HALtheWise/POE-lab3/version-2/libraries.md

# Libraries needed to build

In order to successfully build and install this program, you need to copy the following libraries into your sketchbook libraries directory (`~/Arduino/libraries` on Linux)

- [Adafruit v2 motor shield library](https://learn.adafruit.com/adafruit-motor-shield-v2-for-arduino/install-software)
- [Arduino PID library](https://github.com/br3ttb/Arduino-PID-Library/)
