HALtheWise/POE-lab3/report.pdf

# PoE Lab 03 : Line-Following Robot

## Yoonyoung Cho, Eric Miller

## October 13 2016

# 1 Introduction

Figure 1: Our Line Follower architecture, a two-wheeled differential drive robot equipped with two IR reflectance sensors positioned at the front.

In implementing the line-follower robot, we adopted three different, yet complementary schemes for control algorithms: Bang-Bang, PID, and Memory-Based control. In parallel to development of these methods, we also developed a simulator that would visualize a virtual hardware interface with native arduino code as a test bench for later phases in development and debugging.

# 2 Hardware

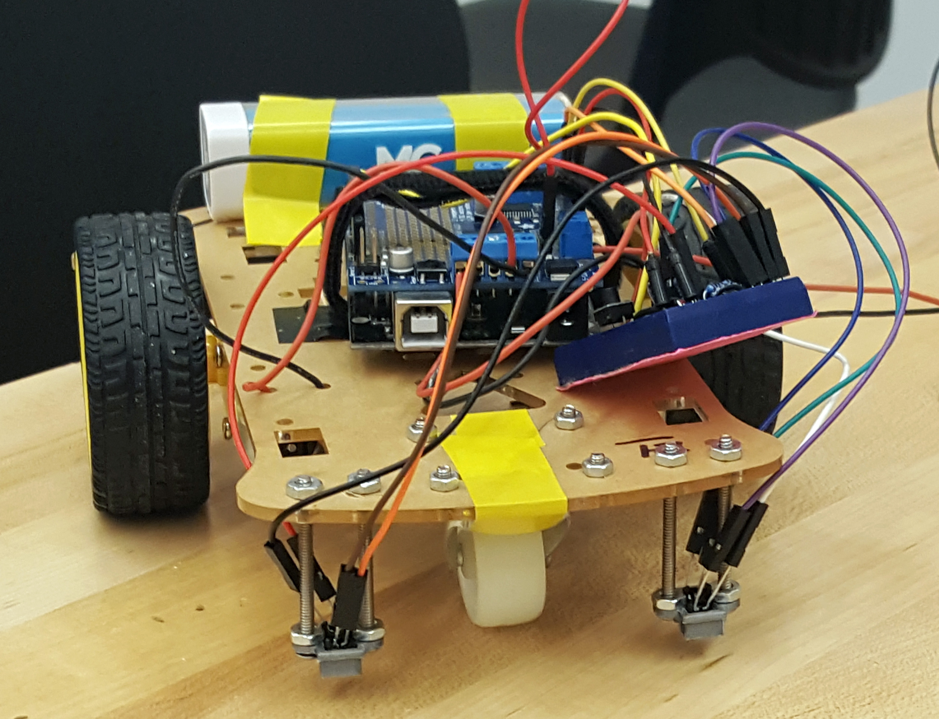
[picture p3: figure]

Figure 2: Final assembly of our robot.

In order to optimize for the reaction time from when the sensor detects a change in the environment, we reversed the orientation of the chassis so that what would otherwise be front would be the back side: i.e. we turned the Tadpole architecture to Delta.

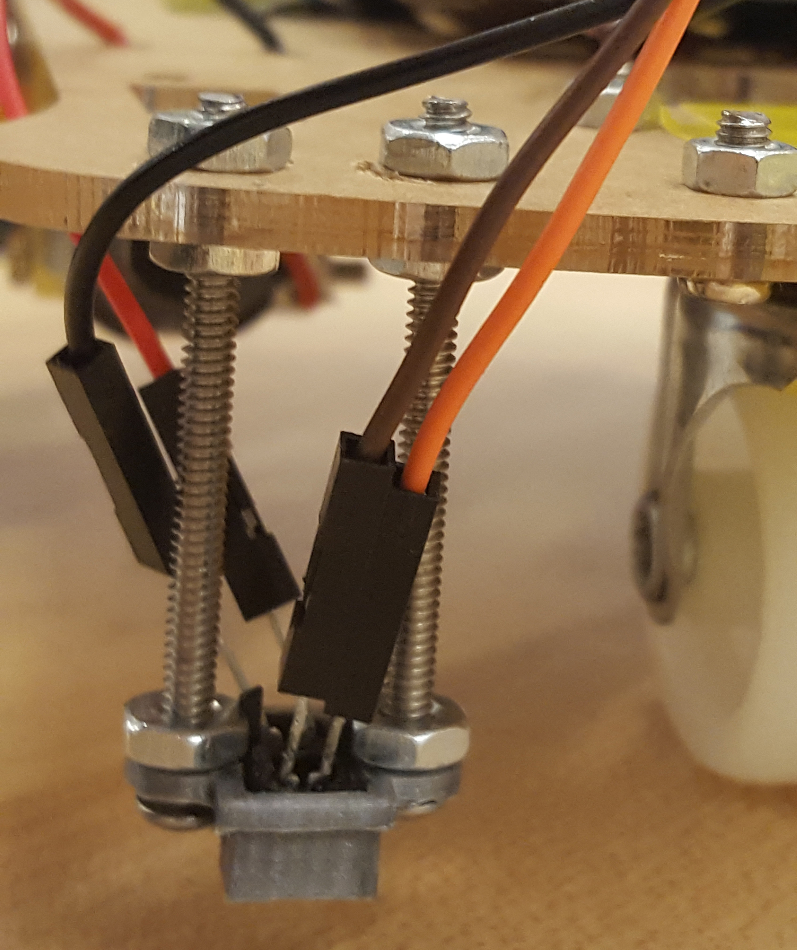
[picture p4: figure]

Figure 3: Mount for the IR reflectance sensor.

We have noticed that the sensor calibration was highly sensitive to the height at which the sensor was mounted; i.e.

### r = htan(fov/2)

where h is the height of the IR sensor, fov is its generic field of view, and r is the radius of the conical section model from which the sensor will poll the values. In addition to this, the signal strength would depend heavily on h as well, as some of the reflected light gets dissipated to the atmosphere, etc. To this end, we designed a minimalistic adjustable-height mount that operates with nuts and bolts, which made it not only convenient to disassemble, but also possible to rapidly adjust the calibration parameters as needed.

# 3 Control

## 3.1 BangBang

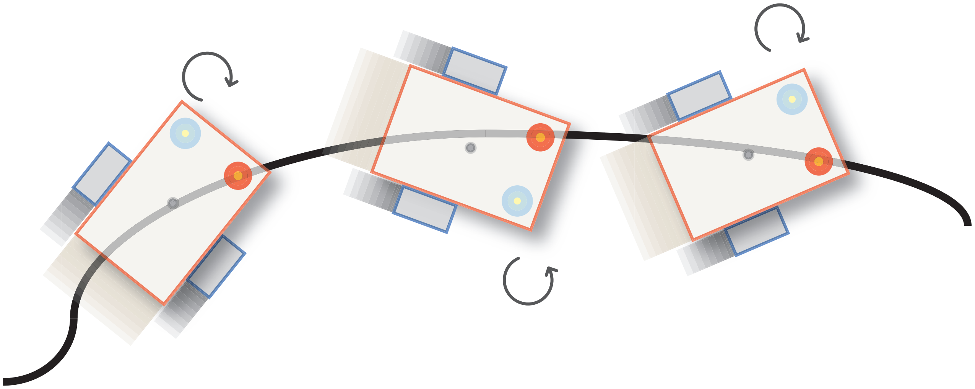
[picture p5: figure]

Figure 4: Simplified diagram that illustrates behavior of the Bang-Bang controller.

As an initial testing step, we employed the classical control algorithm for the Line-Follower Robot: BangBang. With Bang-Bang control, the robot is, at any given moment, under either of the two states: turning left or turning right. Because the robot cannot incorporate past trajectory into its decision-making process, its decisions are momentary and quite extreme, and the robot is always turning. Whereas this is certainly not optimal, the robot will follow the line in an oscillatory trajectory as the line would always be contained within the perimeters of the two sensors.

## 3.2 PID Control

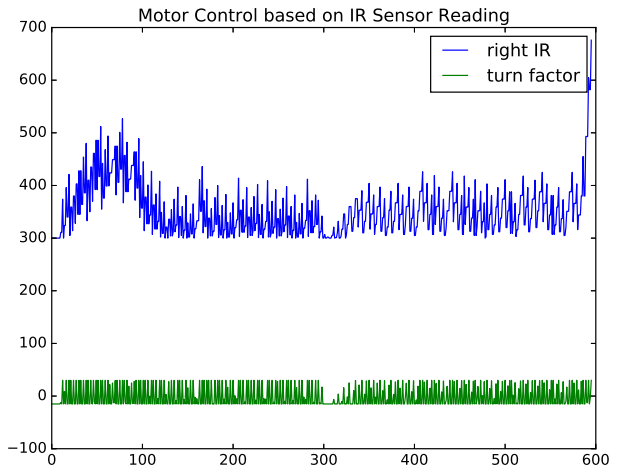
[picture p6: figure]
right IR turn factor

700 | Motor Control based on IR Sensor Reading

### Figure 5: Sensor vs. Motor output graph (run in simulator)

Unlike Bang-Bang control, where there are only two possible states in which the car could be in, the PID control can evaluate the error function in continuous space, which tends to result in a lot smoother trajectory. Our PID controller governed the turning factor of the robot: fixing the forward velocity of the robot essentially constrains the problem such that the control target and the error term collapses into a one-dimensional PID loop for determining sideways motion, i.e.

### ept = (1 + 1) irl − 300

800 − 300

− 1

ei

### t = ei

t−1 + ept dt

### edt =

ept − ept−1
dt

### et = kpept + kiei

### t + kdedt

### pl = pfw + etptn pr = pfw − etptn

Where e, p, l, r, fw, tn, and t represents error, power, left, right, forward-factor, turn-factor, and time, respectively. 300 and 800 are the empirical response readings¹ we have obtained from the Infrared sensor, distinguishing the tape and floor parts.
With untuned PID control trial to roughly verify that the code was working as intended, we obtained a time of 1:13 around the track. It should be noted that during the memorization phase of our final control algorithm, the PID controller (despite frequent stops in order to record the sectional path information) completed the track in less than a minute.

1voltage readings that map the ranges 0-255 to 0-5V.

## 3.3 Memory Prediction

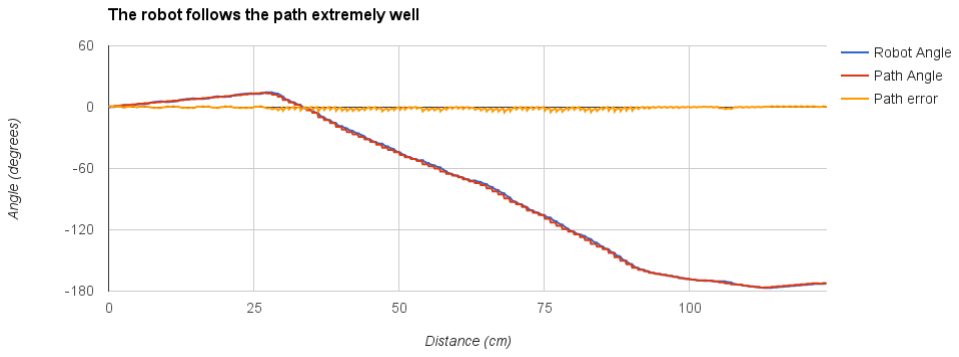
[picture p7: figure]

Figure 6: A snapshot of the pose of the robot along a segment in the path during one of the runs; the path is straight in the beginning (nearly constant angle) until a major 180 degree turn from 30cm until 90cm.

While PID is an incredibly powerful tool, its benefits primarily shine in situations where the behavior of the system varies unpredictably with time. At first glance, a line follower seems like a prime example of this because the shape of the upcoming line is unknown, but in reality, the nature of the course as a closed loop that is permanently affixed to the floor means that the path of the line is actually predictable, and that predictability can be harnessed to enhance the performance of the robot significantly. This insight gave rise to our third-generation algorithm, the memory-prediction follower, which circumnavigates the course twice, using the first run to collect readings on the precise curvature of the course and the second run to use those readings for improving the speed of the navigation.
Intuitively, this task would be easy if the behavior of the motors was perfectly repeatable from run to run because it would be possible to simply record the outputs on the first run and replay them faster for the second run. In reality, the low-quality DC motors we were provided are not anywhere near perfectly repeatable, as demonstrated in Figure 8, and exhibit variations of up to 10% from predictable behavior. We likely could have decreased that error substantially by incorporating true encoders onto the robot, but we wanted to stay within the letter of the lab description by using only the two IR sensors as input devices.

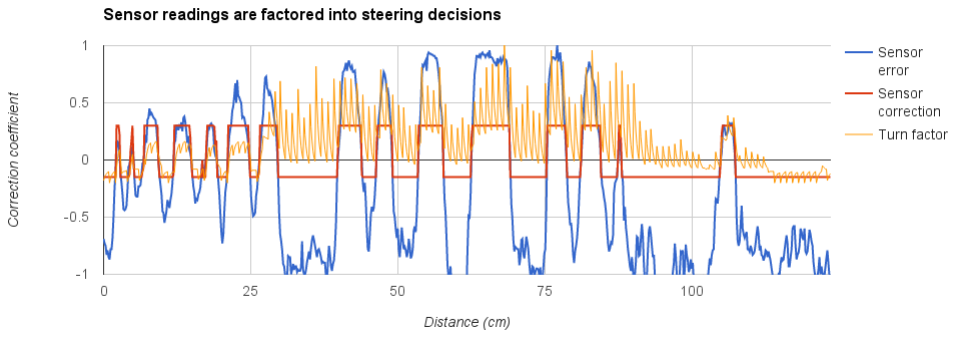
[picture p8: figure]

Figure 7: Sensor data is factored into the final steering corrections (shown in orange) but most of the input comes from error relative to the memorized path.

Because the encoder data we are generating from the motor commands is highly inaccurate, we needed to fuse it with traditional line sensor readings for it to be useful. We did this in two ways. One line sensor (after calibration scaling) was used as a source of a PID loop to update the robot’s estimated orientation in a way akin to following the line. We made the rates on this loop substantially lower than they would be for a pure sensor-based following solution because we could take advantage of the map data collected on the previous run. We placed the other sensor several inches away, much farther than a normal two-sensor follower, and used it exclusively to detect abrupt changes in curvature direction. These changes were used to reset the ”distance travelled” component of the robot’s position estimate. Every time the curvature changed, these two sensors switch roles, guaranteeing that the ”following” sensor will always be on the interior (concave) portion of the curving line.
By running this procedure without prior map data (and at low speed) we were able to built a map composed of seven segments that together build up the course. We stored these segments as lists of floating point values representing the estimated angle of the line at each point in relation to the angle at the start of that segment, with one value stored per centimeter of course. By using separate segments, we allowed ourselves to allocate appropriate amounts of memory and store configuration values associated with each piece of the course. Storing absolute angles instead of rates of curvature was intended to allow efficient computation of drive instructions from any point to any other, although either decision would likely have fallen within our performance requirements.

# 4 Calibration

## 4.1 Motor Characterization

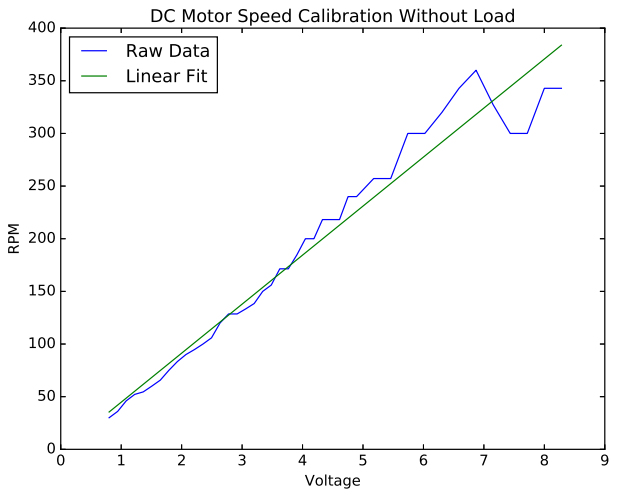
[picture p9: figure]

### Figure 8: Calibration Curve

In order to obtain better data with dead-reckoning, it was essential to have a reasonably precise estimate of the correlation between the power input to the motors and the output velocity. In order to characterize the

### motors, Below are the thus obtained relations:

### r = 3.25cm ω = 2π(46.55p − 1.80)rd/mn

### ~v = ωr

### = 6.5π(46.55p − 1.80)cm/mn

This data was obtained by attaching the tape on the shaft of the motors and counting the number of times that a tape would pass through a certain point in space within a defined amount of time; in practice, this was done by simply placing a finger in the trajectory of the tape and counting the number of collisions over a minute.

## 4.2 IR Reflectance Sensor Calibration

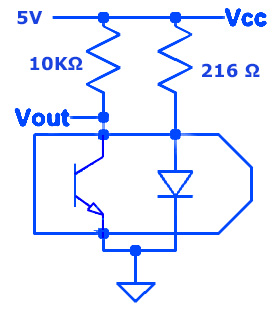
[picture p10: figure]

### Figure 9: Final schematics for interfacing with the IR Reflectance Sensor

The calibration process for the IR reflectance sensor was more of a guess-and-check binary search for the right resistor value that can distinguish between the reflectance responses from the floor and the tape. In order to smooth out the possible noise, we polled the readings for a set duration of the during the loop and updated the values at 10 milliseconds, which was significant enough to cancel the noise but small enough to facilitate rapid reaction.

# 5 Simulation

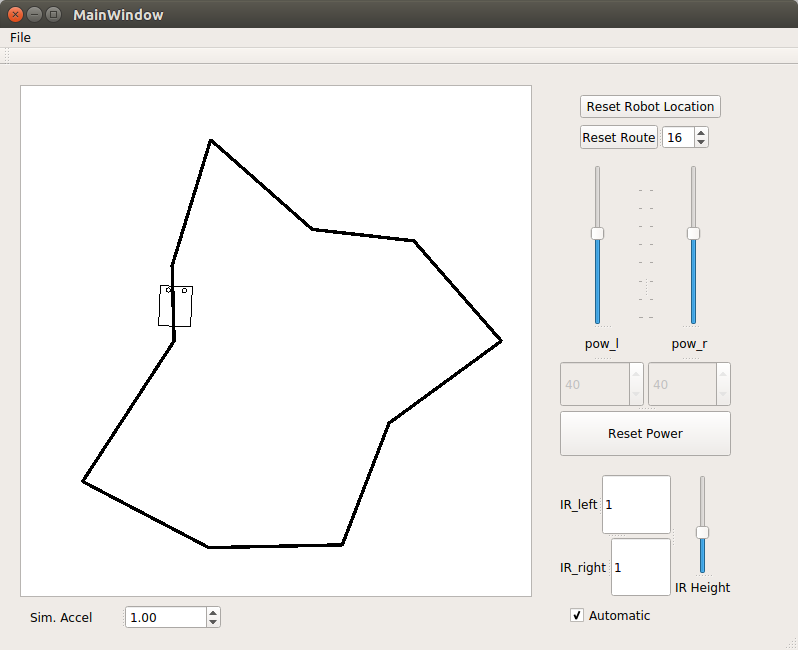
[picture p11: figure]

### Figure 10: Snapshot of the simulation during one of its autonomous runs

Initially, we developed the simulation as test bench for the software code before the chassis arrived for hardware integration testing. However, the process was delayed such that it was completed around the same

### time as the robot. At this point, we sought to use the simulator to fine-tune the kp, ki , and kd parameters, as

well as the offset and the position of the IR sensors, but it quickly turned out that adjusting those parameters didn’t take much effort.
What we ultimately ended up doing is to use the simulator as a relatively idealized environment, in parallel to the physical interaction of the robot with the actual course, where the inherent environmental noise and hardware limitations do not affect the logics of the code. Whereas we did not have time to actually utilize its powers as an optimization platform, it would be a reasonable next step to do so.

## 5.1 Kinematics

In the differential drive robot, the velocities of the two motor are responsible for dictating the motion of the

### robot; i.e. the two signals can be mixed to form the next-state estimate as follows:

The instantaneous center of curvature, denoted ICC, is the imaginary center of rotation along which the

### robot will rotate. it is found by²

:

### ICC = (x − Rsinθ, y + Rconsθ)

thus, at t = t + δt,

x

0
y

0
θ

0

- =

### cos(wδt) −sin(wδt) 0

sin(wδt) | cos(wδt) | 0
0 | 0 | 1

### x − ICCx y − ICCy

θ

- +

### ICCx ICCy wδt

# 6 Results & Reflection

Our robot, on its memorized run, was able to go through the course in under 30 seconds. [Demo Video] (https://www.youtube.com/watch?v=YWfVlXhnvgI) When we were electing to broaden the scope of this project such that the robot would take advantage of accumulated knowledge of the course from history, we knew we were taking on a task that was potentially impossible, and certainly very hard. Although we probably over-scoped the problem some, particularly by refusing to use encoders, we are proud we managed to make it work at all, let alone with the speed we eventually demonstrated.
Our robot’s coding strategy is more prone to external disturbances as a result of high reliance on odometry, but it has the potential of a far higher maximum speed: its anticipation of future positions and low reliance³ on IR sensor readings on its memorized run removes the dependency on the rate of the control loop, and could potentially allow it to perform at or near the limit of motor speed. With a few more sensors, we believe a map-based approach like ours would demonstrate clear superiority, and with one sensor, PID-like (stateless) approaches are probably best, but with the middle-ground of two line sensors, it isn’t clear which approach is superior.

2Refer to [this document] (https://chess.eecs.berkeley.edu/eecs149/documentation/differentialDrive.pdf) for more detailed derivation. 3around 10%

# 7 Appendix: Code

## 7.1 Memory-Prediction Implementation

### Main code (.ino)

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

7
8 #i n cl u d e <s t d l i b . h>

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

17
18 | // Setup s t a t e machine f o r r o b o t
19 | byte s t a t e = 1 ;
20 | c o n s t byte STATE STOP = 0 ;
21 | c o n s t byte STATE MEMORIZE = 1 ;
22 | c o n s t byte STATE REPLAY = 2 ;

23
24 | // I n cl u d e path management code
25 | #i n cl u d e ”odometry . h”
26 | #i n cl u d e ” p a th s . h”

27
28 // C o n t r olli n g c o n s t a n t s

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

31
32 | c o n s t i n t FORWARD POWER INITIAL = 3 0; // 0 . . . 2 5 5
33 | c o n s t i n t TURN POWER INITIAL = 3 0; // 0 . . . 2 5 5

34
35 c o n s t f l o a t OUTER TURN LIMIT = 0 . 0 5 ;

36
37 c o n s t i n t POWER REPLAY = 4 0; // 0 . . . 2 5 5

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

40
41 c o n s t byte SMOOTHING LENGTH = 4 ;

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

45
46 | c o n s t i n t MIN SENSOR LEFT | = 3 6 0;
47 | c o n s t i n t MAX SENSOR LEFT | = 7 8 0;
48 | c o n s t i n t MIN SENSOR RIGHT | = 6 0 0;
49 | c o n s t i n t MAX SENSOR RIGHT | = 8 8 0;

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

54
55 | A d a f r ui t M o t o r S hi el d AFMS = A d a f r ui t M o t o r S hi el d ( ) ;
56 | Ada fruit DCMotor ∗ l e f tM o t o r | = AFMS. getMotor ( 1 ) ;
57 | Ada fruit DCMotor ∗ ri gh tM o t o r = AFMS. getMotor ( 2 ) ;

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

61

62
63 i n t l e f t P o w e r = 0 , ri gh tP owe r = 0 ; // r an ge −2 5 5... 2 5 5

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

66
67 Pose r ob o tP o se ;

68
69 | Path path1 ( 2 0 0 , f a l s e ) ;
70 | Path path2 ( 1 0 0 , t r u e ) ;
71 | Path path3 ( 6 0 0 , f a l s e ) ;
72 | Path path4 ( 1 5 0 , t r u e ) ;
73 | Path path5 ( 2 0 0 , f a l s e ) ;
74 | Path path6 ( 1 0 0 , t r u e ) ;
75 | Path path7 ( 1 0 0 , f a l s e ) ;

76
77 | Path ∗ p a th s [ ] = {&path1 , &path2 , &path3 , &path4 , &path5 , &path6 , &path7 } ;
78 | c o n s t byte numPaths = 7 ;
79 | byte c u r r e n t P a t h I d = 0 ;

80
81 Path ∗ cu r ren tP a th = p a th s [ c u r r e n tP a t h I d ] ;

82
83 | // Setup PID c o n t r o l l e r
84 | d ouble P IDe r ro r =0, P ID se tp oin t =0, PIDoutput ;
85 | d ouble kp=1, ki =0,kd=0;

86
87 PID pid (&PIDerror , &PIDoutput , &P ID se tpoin t , kp , ki , kd , DIRECT) ;

88
89 | v oid se tup ( )
90 | {
91 | AFMS. b e gi n ( ) ;

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

100
101 l a s tAc ti onTime = m i l l i s ( ) ;

102
103 | // I n i t i a l i z e PID c o n t r o l l e r p a r ame te r s
104 | pid . SetMode (AUTOMATIC) ;
105 | pid . SetSampleTime (LOOP DURATION − 2 ) ;
106 | pid . Se tOu tpu tLimi t s ( −1, 1 ) ;

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

117
118 | // Used t o moderate debugging p r i n t o u t s with modulo .
119 | i n t loopCount = 0 ;

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

145

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

151
152 | i f ( s t a t e == STATE REPLAY) {
153 | // The memorizeLine f u n c ti o n d e ci d e d t o change t o STATE REPLAY
154 | // T r a n si ti o n from STATE MEMORIZE t o STATE REPLAY

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

157
158 | s t o p ( ) ;

159
160 | f o r ( i n t i =0; i<numPaths ; i++){
161 | p a th s [ i ]−>smooth (SMOOTHING LENGTH) ;

162
163 | S e r i a l . p r i n t l n ( i ) ;
164 | p a th s [ i ]−>writeOut ( ) ;
165 | }

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

171
172 | // Re se t t o the f i r s t path
173 | c u r r e n t P a t h I d = 0 ;
174 | cu r ren tP a th = p a th s [ 0 ] ;

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

179
180 | } e l s e i f ( s t a t e == STATE REPLAY) {

181
182 | r e pl a y Li n e ( l e f tA v g , rightAvg , dt ) ;

183
184 | i f ( loopCount % 50 == 0 ) {
185 | w r i t e P o s e S e r i a l ( ) ;
186 | }

187
188 | } e l s e {
189 | s t o p ( ) ;
190 | }

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

195

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

235
236 pid . Compute ( ) ;

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

251
252 | l e f t P o w e r = FORWARD POWER INITIAL + t u r nF a c t o r ∗ TURN POWER INITIAL;
253 | ri gh tP owe r | = FORWARD POWER INITIAL − t u r nF a c t o r ∗ TURN POWER INITIAL;

254

255
256 // Step 3 : Record the c u r r e n t motion i n t o the path .

257 cu r ren tP a th−>attemptUpdate ( &r ob o tP o se ) ;

258

259
260 // Step 4 : de te rmine whether the r ob o t has ended the c u r r e n t segment

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

269

270
271 | s t o p ( ) ;
272 | // d el a y ( 5 0 0 ) ;
273 | r ob o tP o se . r e s e t ( ) ;

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

282
283 | }

284
285 | // P ri n t debug i n f o rm a ti o n
286 | i f ( loopCount % 50 == 0 ) {
287 | w r i t e P o s e S e r i a l ( ) ;
288 | }
289 | }

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

293
294 | // Step 0 : Handle e x c e p ti o n f o r c o n t r o l p a r ame te r s on the 5 th segment ( i d =4)
295 | d ouble awayAdjustAmount = LINE ANGLE ADJUSTMENT RATE AWAY;
296 | i f ( c u r r e n tP a t h I d == 4 ) {
297 | awayAdjustAmount ∗= 1 . 8 ;
298 | }

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

313
314 r ob o tP o se . angleFrom += l i n e C o r r e c t i o n ;

315

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

318
319 PathPoint ∗ t a r g e t = cu r ren tP a th−>g e t P oi n t ( r ob o tP o se . di s tAl o n g ) ;

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

322 d ouble p a thE r r o r = t a r g e t −>wrappedAngle − r ob o tP o se . angleFrom ;

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

326
327 | l e f t P o w e r = POWER REPLAY ∗ ( 1 + t u r nF a c t o r ) ;
328 | ri gh tP owe r | = POWER REPLAY ∗ ( 1 − t u r nF a c t o r ) ;

329
330 // Step 3 : Determine whether t h i s segment o f path i s f i n i s h e d

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

337
338 | s t o p ( ) ;
339 | // d el a y ( 2 0 0 ) ;
340 | r ob o tP o se . r e s e t ( ) ;

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

348
349 | }

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

389 i f ( S e r i a l . a v a i l a b l e ( ) > 0 ) {

390
391 | S e r i a l . setTimeout ( 1 0 0 ) ;
392 | // Read f i r s t number from s e r i a l stream
393 | kp = S e r i a l . p a r s eFl o a t ( ) ;
394 | S e r i a l . re ad ( ) ;
395 | // Read sec ond number from s e r i a l stream
396 | ki = S e r i a l . p a r s eFl o a t ( ) ;
397 | S e r i a l . re ad ( ) ;
398 | // Read t h i r d number form s e r i a l stream
399 | kd = S e r i a l . p a r s eFl o a t ( ) ;
400 | S e r i a l . re ad ( ) ;

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

406
407 | pid . SetTunings ( kp , ki , kd ) ;
408 | w ri t e T u ni n g s S e ri al ( ) ;
409 | }
410 | }

411
412 | v oid w r i t e P o s e S e r i a l ( ) {
413 | S e r i a l . p ri n t ( ”Pose i s : \ t ” ) ;
414 | r ob o tP o se . writeOut ( ) ;
415 | S e r i a l . p r i n t l n ( ) ;
416 | }

417
418 | v oid w ri t e T u ni n g s S e ri al ( )
419 | {
420 | S e r i a l . p r i n t l n ( ”Tunings s e t t o ( kp , ki , kd ) = ” ) ;
421 | S e r i a l . p ri n t ( ”\ t ( ” ) ;
422 | S e r i a l . p ri n t ( kp ) ;
423 | S e r i a l . p ri n t ( ” , ” ) ;
424 | S e r i a l . p ri n t ( ki ) ;
425 | S e r i a l . p ri n t ( ” , ” ) ;
426 | S e r i a l . p ri n t ( kd ) ;
427 | S e r i a l . p ri n t ( ” ) \n” ) ;
428 | }

429
430 | v oid s t o p ( ) {
431 | l e f t P o w e r = 0 ;
432 | ri gh tP owe r = 0 ;
433 | d ri veM o t o r s ( ) ;
434 | }

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

439
440 n o rm alizeP owe r s (&l e f tP ow e r , &rightPower , 2 5 5 ) ;

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

454
455 }

456
457 | v oid getMeasurements ( i n t ∗ l e f tR e a d , i n t ∗ ri gh tRe ad )
458 | {
459 | ∗ l e f t R e a d = analogRead ( l e f t S e n s o r P i n ) ;
460 | ∗ ri gh tRe ad = analogRead ( ri g h t S e n s o r Pi n ) ;
461 | }

### Path library (.h)

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

9
10 | PathPoint ( ) ;
11 | } ;

12
13 | PathPoint : : PathPoint ( v oid ) {
14 | wrappedAngle = 0 ;
15 | }

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

26
27 b o ol u s e L e f t S e n s o r ; // = f a l s e ;

28
29 | v oid writeOut ( v oid ) ;
30 | b o ol attemptUpdate ( Pose ∗ p o se ) ;
31 | v oid smooth ( byte smoothingLength ) ;
32 | PathPoint ∗ g e t P oi n t ( d ouble di s tAl o n g ) ;
33 | } ;

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

40
41 p oi n t s = ( PathPoint ∗) m all oc ( s i z e o f ( PathPoint ) ∗ l e n g t h ) ;

42
43 | f o r ( i n t i = 0 ; i < a l l o c a t e d P o i n t s ; ++i )
44 | {
45 | p oi n t s [ i ] = PathPoint ( ) ;
46 | }

47
48 | p oi n t s [ 0 ] . wrappedAngle = 0 ;
49 | }

50
51 | PathPoint ∗Path : : g e t P oi n t ( d ouble di s tAl o n g ) {
52 | i n t inde x = min ( di s tAl on g , u s e d P oi n t s − 1 ) ;
53 | i f ( inde x < 0 )
54 | {
55 | r e t u r n NULL;
56 | }
57 | r e t u r n &p oi n t s [ inde x ] ;
58 | }

59

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

96
97 | p oi n t s [ i ] . wrappedAngle = a v e r a g e ;
98 | }
99 | }

### Odometry code (.h)

1 #i n cl u d e <Arduino . h>

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

18
19 | Pose : : Pose ( ) {
20 | r e s e t ( ) ;
21 | }

22
23 | v oid Pose : : writeOut ( v oid ) {
24 | S e r i a l . p ri n t ( ” (d , t h e t a ) = ( ” ) ;

25 | S e r i a l . p ri n t ( di s tAl o n g ) ;
26 | S e r i a l . p ri n t ( ” , ” ) ;
27 | S e r i a l . p ri n t ( angleFrom ) ;
28 | S e r i a l . p ri n t ( ” ) ” ) ;
29 | }

30
31 | v oid Pose : : r e s e t ( ) {
32 | di s tAl o n g = 0 ;
33 | angleFrom = 0 ;
34 | }

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

57
58 | d ouble l e f t P ow e rF r a c | = ad justPower ( l e f t P o w e r ) ;
59 | d ouble ri gh tP owe rF r ac = ad justPower ( ri gh tP owe r ) ;
60 | d ouble fo rwa rdSpeed = ( l e f t P ow e rF r a c + ri gh tP owe rF r ac ) / 2 ∗ MAX FORWARD SPEED;
61 | d ouble turnSpeed = ( ri gh tP owe rF r ac − l e f t P ow e rF r a c ) / 2 ∗ MAX TURN SPEED;

62
63 | di s tAl o n g += fo rwa rdSpeed ∗ tim e s t e p / 1 0 0 0 . 0 ;
64 | angleFrom += turnSpeed ∗ tim e s t e p / 1 0 0 0 . 0 ;
65 | }

## 7.2 Simulator Implementation

The simulator is a relatively large project with a lot of split definitions, so including all of them here would be impractical. Below are several more relevant parts that are directly related to either the computations or the functions of the simulator. For the full documentation, please visit the github link. (https://github.com/HALtheWise/POE-lab3/tree/simulator-memory)

### 7.2.1 Arduino Interface

### Adafruit MotorShield.h (declaration)

1 | #i f n d e f ADAFRUIT MOTORSHIELD H
2 | #d e f i n e ADAFRUIT MOTORSHIELD H

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

9
10 #d e f i n e FORWARD 1

11
12 #d e f i n e BACKWARD 2

13
14 | c l a s s Ada fruit DCMotor {
15 | p r i v a t e :
16 | i n t pin ;
17 | i n t speed ;
18 | p u bli c :
19 | Ada fruit DCMotor ( i n t pin ) ;
20 | v oid s e t S p e e d ( i n t ) ;
21 | v oid run ( byte&) ;
22 | } ;

23
24 | c l a s s A d a f r ui t M o t o r S hi el d
25 | {
26 | p r i v a t e :
27 | Ada fruit DCMotor ∗ m o t o r l e f t , ∗ m o t o r ri g h t ;
28 | p u bli c :
29 | A d a f r ui t M o t o r S hi el d ( ) ;
30 | ˜ A d a f r ui t M o t o r S hi el d ( ) ;
31 | v oid b e gi n ( ) ;
32 | Ada fruit DCMotor ∗ getMotor ( i n t ) ;
33 | } ;

34
35 #e n d i f // ADAFRUIT MOTORSHIELD H

### Adafruit MotorShield.cpp (definition)

1 #i n cl u d e ” A d a f r ui t M o t o r S hi el d . h”

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

5
6 Ada fruit DCMotor : : Ada fruit DCMotor ( i n t pin ) : pin ( pin ) {

7
8 }

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

17
18 | i f ( r o b o t ) {
19 | swi t c h ( pin ) {
20 | c a s e 1 : // l e f t
21 | robot−>setPowerL ( d i r ∗ speed ) ;
22 | break ;
23 | c a s e 2 :
24 | robot−>setPowerR ( d i r ∗ speed ) ;
25 | break ;
26 | }
27 | }

28
29 }

30
31 | v oid Ada fruit DCMotor : : s e t S p e e d ( i n t speed ) {
32 | t hi s −>speed = speed ;
33 | }

34
35 | A d a f r ui t M o t o r S hi el d : : A d a f r ui t M o t o r S hi el d ( )
36 | {
37 | t hi s −>m o t o r l e f t = new Ada fruit DCMotor ( 1 ) ;
38 | t hi s −>m o t o r ri g h t = new Ada fruit DCMotor ( 2 ) ;
39 | }

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

51
52 | v oid A d a f r ui t M o t o r S hi el d : : b e gi n ( ) {
53 | // don ’ t need t o do any thin g h e r e
54 | }

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

### arduino.h (declaration)

1 | #i f n d e f ARDUINO H
2 | #d e f i n e ARDUINO H

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

5
6 #d e f i n e BIN ( 2 )

7
8 | c o n s t i n t A0 = 0xA0 ;
9 | c o n s t i n t A1 = 0xA1 ;

10
11 | #i n cl u d e <i o s t re am>
12 | #i n cl u d e <b i t s e t >

13
14 | #i n cl u d e ” u t i l s . h”
15 | #i n cl u d e ”mainwindow . h”
16 | #i n cl u d e ” r o b o t . h”

17
18 | c l a s s | S e r i a l {

19
20 | p u bli c :
21 | v oid b e gi n ( i n t ) {
22 | | // i g n o r e baud r a t e
23 | }

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

30
31 | template<typename T>
32 | v oid p r i n t (T val , i n t f l a g ) {
33 | | i f ( f l a g == BIN ) {
34 | | s t d : : c ou t << s t d : : b i t s e t <8>( v al ) ;
35 | | }
36 | | // . . . not h a n dli n g o t h e r f l a g s ye t
37 | }

38
39 | template<typename T>
40 | v oid p r i n t l n (T v al ) {

41 | | s t d : : c ou t << v al << s t d : : e n dl ;
42 | }

43
44 | v oid p r i n t l n ( ) {
45 | | s t d : : c ou t << s t d : : e n dl ;
46 | }
47 | } ;

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

51
52 // Arduino APIs

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

59
60 #e n d i f // ARDUINO H

### arduino.cpp (definition)

1 | #i f n d e f ARDUINO H
2 | #d e f i n e ARDUINO H

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

5
6 #d e f i n e BIN ( 2 )

7
8 | c o n s t i n t A0 = 0xA0 ;
9 | c o n s t i n t A1 = 0xA1 ;

10
11 | #i n cl u d e <i o s t re am>
12 | #i n cl u d e <b i t s e t >

13
14 | #i n cl u d e ” u t i l s . h”
15 | #i n cl u d e ”mainwindow . h”
16 | #i n cl u d e ” r o b o t . h”

17
18 | c l a s s | S e r i a l {

19
20 | p u bli c :
21 | v oid b e gi n ( i n t ) {
22 | | // i g n o r e baud r a t e
23 | }

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

30
31 | template<typename T>
32 | v oid p r i n t (T val , i n t f l a g ) {
33 | | i f ( f l a g == BIN ) {
34 | | s t d : : c ou t << s t d : : b i t s e t <8>( v al ) ;
35 | | }
36 | | // . . . not h a n dli n g o t h e r f l a g s ye t
37 | }

38
39 | template<typename T>
40 | v oid p r i n t l n (T v al ) {
41 | | s t d : : c ou t << v al << s t d : : e n dl ;
42 | }

43
44 | v oid p r i n t l n ( ) {
45 | | s t d : : c ou t << s t d : : e n dl ;

46 | }
47 | } ;

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

51
52 // Arduino APIs

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

59
60 #e n d i f // ARDUINO H

### 7.2.2 System Definition

### Route.h (declaration)

1 | #i f n d e f ROUTE H
2 | #d e f i n e ROUTE H

3
4 | #i n cl u d e <QVector>
5 | #i n cl u d e <QPointF>
6 | #i n cl u d e <QPolygonF>
7 | #i n cl u d e <QGraphicsPolygonItem>
8 | #i n cl u d e <QPen>
9 | #i n cl u d e <QString>
10 | #i n cl u d e <QFile>
11 | #i n cl u d e <QTextStream>

12
13 #i n cl u d e ” u t i l s . h”

14
15 | s t r u c t Route
16 | {
17 | //QVector<QPointF> r o u t e ;
18 | QPolygonF p ol y ;
19 | QGraphicsPolygonItem p ol y i t em ;
20 | QPen routePen ;
21 | p u bli c :
22 | Route ( ) ;

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

27
28 | v oid s a ve ( c o n s t QString& fil e n am e ) ;
29 | v oid l o a d ( c o n s t QString& fil e n am e ) ;
30 | } ;

31
32 e x t e r n Route∗ r o u t e ;

33
34 #e n d i f // ROUTE H

### Route.cpp (definition)

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

4
5 | c o n s t d ouble R MIN = PXL DIMS / 8;
6 | c o n s t d ouble R MAX = PXL DIMS / 2;

7
8 Route∗ r o u t e ;

9
10 Route : : Route ( )

11 | {
12 | QBrush r ou teB ru sh = QBrush ( QColor : : fromRgb ( 0 , 0 , 0 ) ,Qt : : S oli d P a t t e r n ) ;
13 | routePen = QPen( routeBrush , c2p ( 1 . 7 ) ) ;
14 | }

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

18
19 | QVector<QPointF> r o u t e ;

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

23
24 | f o r ( i n t i =0; i<n ; ++i ) {
25 | f l o a t t = ( 2 ∗ M PI ) ∗ i / n ;
26 | f l o a t r = R MIN + (R MAX − R MIN) ∗ f l o a t ( rand ( ) ) /RANDMAX;
27 | r o u t e . push back ( QPointF ( x + r ∗ c o s ( t ) , y + r ∗ s i n ( t ) ) ) ;
28 | }
29 | s t d : : c ou t << ”N : ” << n << ” ROUTE SIZE : ” << r o u t e . s i z e ( ) << s t d : : e n dl ;
30 | r e s e t ( r o u t e ) ;
31 | }

32
33 | v oid Route : : r e s e t ( c o n s t QVector<QPointF> &r o u t e ) {
34 | // r e s e t from v e c t o r
35 | p ol y = QPolygonF ( r o u t e ) ;
36 | p ol y i t em . s e tP ol y g o n ( p ol y ) ;
37 | p ol y i t em . se tPen ( routePen ) ;
38 | }

39
40 | v oid Route : : s a ve ( c o n s t QString& fil e n am e ) {
41 | // s a ve r o u t e t o f i l e
42 | QFile f i l e ( fil e n am e ) ;
43 | i f ( f i l e . open ( QIODevice : : ReadWrite ) ) {
44 | QTextStream stream (& f i l e ) ;

45
46 | f o r ( auto& p : p ol y ) {
47 | stream << p . x ( ) << ’ , ’ << p . y ( ) << ’ \n ’ ;
48 | }
49 | }
50 | f i l e . c l o s e ( ) ;
51 | }

52
53 | v oid Route : : l o a d ( c o n s t QString& fil e n am e ) {
54 | // l o a d r o u t e from f i l e
55 | QFile f i l e ( fil e n am e ) ;
56 | i f ( f i l e . open ( QIODevice : : ReadOnly ) ) {
57 | QTextStream stream (& f i l e ) ;
58 | QVector<QPointF> r o u t e ;

59
60 | w hil e ( ! stream . atEnd ( ) ) {
61 | QString l i n e = stream . r e a dLi n e ( ) ;
62 | Q S t ri n gLi s t p t s = l i n e . s p l i t ( ” , ” ) ;
63 | QPointF pt ( p t s [ 0 ] . t oFl o a t ( ) , p t s [ 1 ] . t oFl o a t ( ) ) ;
64 | r o u t e . push back ( pt ) ;
65 | }

66
67 | f i l e . c l o s e ( ) ;
68 | Route : : r e s e t ( r o u t e ) ;
69 | }
70 | }

### Robot.h (declaration)

1 | #i f n d e f ROBOT H
2 | #d e f i n e ROBOT H

3
4 | #i n cl u d e <QObject>
5 | #i n cl u d e <QPointF>

6
7 #i n cl u d e <QPolygonF>

8
9 | #i n cl u d e <QGraphicsRectItem>
10 | #i n cl u d e <QG r aphic sEllip se I tem>

11
12 #i n cl u d e <QGraphicsScene>

13
14 | #i n cl u d e ” u t i l s . h”
15 | #i n cl u d e ” r o b o ti t em . h”

16

17
18 | c l a s s Robot
19 | {

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

37
38 | RobotItem∗ body ;

39
40 | p u bli c :
41 | Robot ( QGraphicsScene& scene ,
42 | QPointF pos , f l o a t the t a ,
43 | QPointF i r O f f s e t , f l o a t h , f l o a t f o v ) ;
44 | ˜Robot ( ) ;

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

52
53 | v oid setPowerR ( i n t r ) ;
54 | v oid setPowerL ( i n t l ) ;

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

58
59 | v oid s e t IRH ei g h t ( f l o a t h ) ;

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

64
65 e x t e r n Robot∗ r o b o t ;

66
67 #e n d i f // ROBOT H

### Robot.cpp (definition)

1 | #i n cl u d e ” u t i l s . h”
2 | #i n cl u d e ” r o b o t . h”

3

4 #i n cl u d e <i o s t re am>

5
6 | // 1 p xl = . 5 cm
7 | // 270 x 270 cm world

8
9 // r o b o t = 20 x16 cm

10
11 Robot∗ r o b o t = n u l l p t r ;

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

16
17 | // RobotBody
18 | Robot : : Robot ( QGraphicsScene& scene , QPointF pos , f l o a t the t a , QPointF i r O f f s e t , f l o a t h ,
| f l o a t f o v ) :
19 | pos ( pos ) ,
20 | t h e t a ( t h e t a ) ,
21 | i r O f f s e t ( i r O f f s e t ) ,
22 | h ( h ) ,
23 | f o v ( f o v ) ,
24 | c r ( coneRadius ( h , f o v ) )
25 | {
26 | v e l l = v e l r = 0 . ;

27
28 | body = new RobotItem ( pos , QPointF (ROBOT LENGTH,ROBOT WIDTH) , i r O f f s e t , the t a , c r ) ;
29 | // RobotItem w i l l t a ke c a r e o f g r a p hi c s
30 | s c e n e . addItem ( body ) ;
31 | }

32
33 | Robot : : ˜ Robot ( ) {
34 | i f ( body ) {
35 | d e l e t e body ;
36 | body = n u l l p t r ;
37 | }
38 | }

39
40 | v oid Robot : : r e s e t ( QPointF p , f l o a t t ) {
41 | pos=p ; t h e t a=t ;
42 | body−>s e t P o s ( pos , t h e t a ) ;
43 | }

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

49
50 | t h e t a = atan2 ( pos . y ( ) − d s t y , d s t x − pos . x ( ) ) ;

51
52 }

53
54 | v oid Robot : : move ( f l o a t d el t a , f l o a t d the t a ) {
55 | t h e t a += d the t a ∗ DT;
56 | pos += d e l t a ∗ QPointF ( c o s ( t h e t a ) , −s i n ( t h e t a ) ) ∗ DT;
57 | update ( ) ;
58 | }

59
60 | v oid Robot : : update ( ) {
61 | f l o a t w = ( v e l r − v e l l ) / WHEEL DISTANCE;
62 | i f (w != 0 ) {
63 | f l o a t R = ( v e l l + v e l r ) / ( 2∗w) ;

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

68
69 | f l o a t x = pos . x ( ) ;
70 | f l o a t y = pos . y ( ) ;

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

73
74 | pos . setX (
75 | c o s (−w∗DT) ∗ ( x − i c c x ) +
76 | −s i n (−w∗DT) ∗ ( y − i c c y ) +
77 | i c c x
78 | ) ;
79 | pos . setY (
80 | s i n (−w∗DT) ∗ ( x − i c c x ) +
81 | c o s (−w∗DT) ∗ ( y − i c c y ) +
82 | i c c y
83 | ) ;
84 | t h e t a += w ∗ DT;
85 | } e l s e {
86 | // i f w == 0 , then d i v i s i o n by z e r o would be bad . .
87 | // s i n c e i t ’ s a s p e c i a l ( and w ell −d e fi n e d ) c a se , we sh ould h andle t h i s
88 | pos += v e l l ∗ QPointF ( c o s ( t h e t a ) , −s i n ( t h e t a ) ) ∗ DT;
89 | }

90

91
92 | body−>s e t P o s ( pos , t h e t a ) ;
93 | }
94 | v oid Robot : : s e t V el o ci t y L ( f l o a t v ) {
95 | v e l l = v ;
96 | }

97
98 | v oid Robot : : s e t V el o ci t y R ( f l o a t v ) {
99 | v e l r = v ;
100 | }

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

107

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

114

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

120
121 | v oid Robot : : s e t IRH ei g h t ( f l o a t h ) {
122 | t hi s −>h = h ;
123 | t hi s −>c r = coneRadius ( h , f o v ) ;
124 | body−>setCR ( t hi s −>c r ) ;
125 | }

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

137
138 | f l o a t cR = coneRadius ( h , f o v ) ;

139 | i n t i cR = round ( cR ) ;

140
141 | i n t n = 0 ;
142 | f l o a t sum l =0;
143 | f l o a t sum r = 0 ;

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

152
153 | sum l += qGray ( c o l l ) / 2 5 5 . 0 ;
154 | sum r += qGray ( c o l r ) / 2 5 5 . 0 ;
155 | ++n ;

156

157
158 | }
159 | }
160 | }

161
162 | // s e t i r v al u e s
163 | i f ( n ) {
164 | i r v a l l = sum l / n ;
165 | i r v a l r = sum r / n ;
166 | }
167 | }

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
