HALtheWise/POE-lab3/images/ir_reader_schem.png

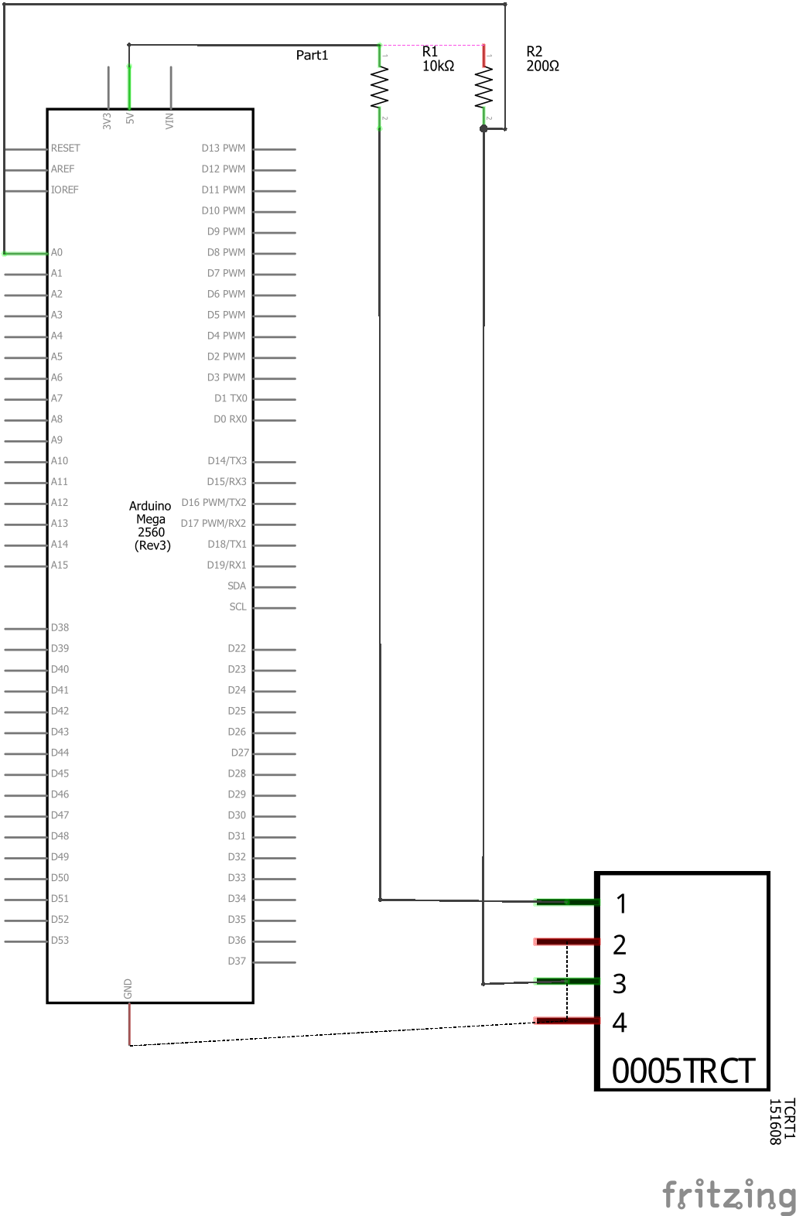
images/ir_reader_schem.png
