HALtheWise/POE-lab3/(commit log)

2016-09-30 Created sensor calibration code with averaging
2016-09-30 Copied calibration code into Version 1.
2016-09-30 Added motor control capability to v1 code
2016-10-01 Finished (untested) first draft at bang-bang control of Arduino robot.
2016-10-04 preliminary testing for IR reflectance sensor done
2016-10-04 adding schematic images
2016-10-04 Added normalizePowers() function to constrain motors to achievable values.
2016-10-04 Moved code to PID based control algorithm
2016-10-07 Added serial reading/writing to PID code
2016-10-08 Added odometry library with handling of robot pose information
2016-10-08 Moved motor powers to be global variables for ease of access elsewhere.
2016-10-09 Added ability to track and write out estimated robot pose
2016-10-09 Tweaks on calibration program
2016-10-09 updating to-do list, completed simulator (no arduino wrapper yet)
2016-10-10 Finished first PID lap
2016-10-10 reminding myself for the voltage monitor
2016-10-11 Transferred lessons from PID code
2016-10-11 Pulled out sensor calibration as constants
2016-10-11 Built code to record a path as it is traversed and print that after the run
2016-10-11 Added ability to replay path (without looking at the sensors)
2016-10-11 Repaired byte wraparound bugs
    [version-2.ino]
2016-10-11 Repaired nasty behavior with recovering from slow loop of transmit and switch cycle.
2016-10-11 Attempted to make the motor speed calibration curve slightly better, we really need to do this properly.
2016-10-11 Improved motor calibration to be slightly sublinear
2016-10-11 Changed calibration for 10/11
2016-10-11 Added line-based corrections into path follow
    [odometry.h]
2016-10-11 Added ability for Paths to specify left or right sensor use
2016-10-12 Reworked line memorization to (hopefully) start handling multiple-segment lines.
    [version-2.ino]
2016-10-12 Extraced use of left sensor to local stack variable
2016-10-12 Determined correct wire orientation
    [odometry.h, version-2.ino]
2016-10-12 Switched to different sensor calibrations for left vs right and updated calibrations for 10/12
2016-10-12 Rebuilt path following to handle sensor input properly and to handle multi-segment courses
2016-10-12 Corrected silly mistake with confusing memorize and follow functions (reverted from commit 0b483da004ef14a14e7671ef34eb6ddde9e07e53)
    [version-2.ino]
2016-10-12 Prevented termination of following before 30cm short of finish line
    [version-2.ino]
2016-10-12 Finished work for 10/12, negating following PID when on left sensor
2016-10-13 modified paths.h to compile, doesn't like default arguments
    [paths.h]
2016-10-13 Began work on Thursday, tweaking refollow PID rate to improve stuff
2016-10-14 Prevented spurious odometry updates
    [odometry.h]
2016-10-14 Good working sensor fusion path following
2016-10-14 Disabled printing of line error and correction
    [version-2.ino]
2016-10-14 Prevented instant termination of path segment recording if both sensors are tripped.
    [version-2.ino]
2016-10-14 Converted path representation to double instead of byte to simplify code and avoid wraparound problems at the cost of increased memory usage.
    [odometry.h, paths.h, version-2.ino]
2016-10-14 Fixed stupid typo (thanks, C++)
    [version-2.ino]
